remmaTech12/drone2/circuit/multicopter/purchase_order/20250331b/T-1JP8W790621A-1sets-bom_filled.xls

PCBWay Bom Quotation, Product No.:T-1JP8W790621A
Item # | *Designator | *Qty | Manufacturer | *Mfg Part # | Description / Value | *Package/Footprint | Mounting Type | Your Instructions / Notes | *Unit Price(1 set) | *Total | *Delivery Time | *PCBWay Note | Customer Reply | PCBWay Update
1 | J2 | 1 |  |  | Conn_01x02_Pin | Connector_PinHeader_2.54mm:PinHeader_1x02_P2.54mm_Vertical | THT | Don’t need to solder. |  |  |  | Please provide exact part number or component URL | Don’t need to solder anything for this component.
2 | U1 | 1 | CXH |  | ESP32-DEVKITC-32E | ESP32-DEVKITC-32E:MODULE_ESP32-DEVKITC-32E | THT | https://www.alibaba.com/product-detail/2-54mm-Pitch-1x19-pins-Header-1600109002943.html『 』Please solder two 1 x 19 pin sockets. |  |  |  | Please provide exact part number or component URL | Please solder 2.54mm pitch female pin header like this. https://www.mouser.jp/ProductDetail/Harwin/M20-7823242?qs=ulE8k0yEMYaI8GORbWnzlA%3D%3D Number: M20-7823242 Manufacturer: Harwin
3 | R15 | 1 | Vishay / Dale | CRCW06035K10FKEC | 5.1kΩ | Resistor_SMD:R_0603_1608Metric | SMD | https://www.mouser.jp/ProductDetail/Vishay-Dale/CRCW06035K10FKEC | $0.185 | $0.185
4 | R20 | 1 | TDK | MMZ1608S102ATA00 | 1kΩ | Resistor_SMD:R_0603_1608Metric | SMD | https://www.mouser.jp/ProductDetail/TDK/MMZ1608S102ATA00?qs=8Kz9Wu9QwqVBjJnYaU1j7g%3D%3D | $0.063 | $0.063
5 | M1,M2,M3,M4,M5,M6 | 6 | JST Sales America Inc. | S2B-PH-K-S | Motor_DC | Connector_JST:JST_PH_S2B-PH-K_1x02_P2.00mm_Horizontal | THT | https://www.digikey.jp/en/products/detail/jst-sales-america-inc/S2B-PH-K-S/926626 | $0.117 | $0.702
6 | C7 | 1 | Vishay / Vitramon | VJ0603Y682KXBAC31X | 6.8nF | Capacitor_SMD:C_0603_1608Metric | SMD | https://www.mouser.jp/ProductDetail/Vishay-Vitramon/VJ0603Y682KXBAC31X | $0.769 | $0.769 | 7-10 Workdays
7 | C1,C2,C3,C4,C5,C11,C12,C13 | 8 | KYOCERA AVX | 0603ZD226MAT2A | 22uF | Capacitor_SMD:C_0603_1608Metric | SMD | https://www.mouser.jp/ProductDetail/KYOCERA-AVX/0603ZD226MAT2A?qs=sSYV1F9c5cE%2FKdrrBmQkqw%3D%3D | $0.598 | $4.784 | 7-10 Workdays
8 | U3 | 1 | JST Sales America Inc. | B7B-PH-K-S | PMW3901 | Connector_JST:JST_PH_B7B-PH-K_1x07_P2.00mm_Vertical | THT | https://www.digikey.jp/ja/products/detail/jst-sales-america-inc/B7B-PH-K-S/926616?productid=926616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 | $0.201 | $0.201
9 | U6 | 1 | JST Sales America Inc. | B7B-PH-K-S | VL53L1X | Connector_JST:JST_PH_B7B-PH-K_1x07_P2.00mm_Vertical | THT | https://www.digikey.jp/ja/products/detail/jst-sales-america-inc/B7B-PH-K-S/926616?productid=926616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 | $0.201 | $0.201
10 | U4 | 1 | Bosch Sensortec | BNO055 | BNO055 | Package_LGA:LGA-28_5.2x3.8mm_P0.5mm | SMD | https://www.mouser.jp/ProductDetail/Bosch-Sensortec/BNO055?qs=QhAb4EtQfbV8Z2YmISucWw%3D%3D | $9.258 | $9.258
11 | R1,R2,R5,R6,R16,R18 | 6 | Bourns | CR0603-JW-101ELF | 100Ω | Resistor_SMD:R_0603_1608Metric | SMD | https://www.mouser.jp/ProductDetail/Bourns/CR0603-JW-101ELF?qs=jAUlru4btJFOerhakJcyhQ%3D%3D | $0.031 | $0.186 | 7-10 Workdays
12 | R22 | 1 | Pulse Electronics | GBK160808T-221Y-N | 220Ω | Resistor_SMD:R_0603_1608Metric | SMD | https://www.mouser.jp/ProductDetail/Pulse-Electronics/GBK160808T-221Y-N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 | $0.050 | $0.050
13 | L1 | 1 | Vishay / Dale | IHLP2020BZER220M5A | 22uH | Inductor_SMD:L_Vishay_IHLP-2020 | SMD | https://www.mouser.jp/ProductDetail/Vishay-Dale/IHLP2020BZER220M5A?qs=Imq1NPwxi76LTZn5EfE7yw%3D%3D | $1.937 | $1.937 | 7-10 Workdays
14 | C6,C8 | 2 | KYOCERA AVX | KAM15AR71C104KM | 0.1uF | Capacitor_SMD:C_0603_1608Metric | SMD | https://www.mouser.jp/ProductDetail/KYOCERA-AVX/KAM15AR71C104KM?qs=Jm2GQyTW%2FbjvjfiJhcHTCg%3D%3D | $0.147 | $0.294
15 | SW1 | 1 | C&K | KMR231NGLFS | SW_Push | Button_Switch_SMD:SW_Push_1P1T_NO_CK_KMR2 | SMD | https://www.mouser.jp/ProductDetail/CK/KMR231NGLFS?qs=sb%252But3Lm4x1Y5NsXXdZx2g%3D%3D | $0.503 | $0.503
16 | R3,R4,R7,R8,R9,R10,R11,R12,R13,R14,R17,R19 | 12 | Vishay / Beyschlag | MCT06030D1002BP500 | 10kΩ | Resistor_SMD:R_0603_1608Metric | SMD | https://www.mouser.jp/ProductDetail/Vishay-Beyschlag/MCT06030D1002BP500?qs=ncxkyCpAYDAJSzgYSRSsnA%3D%3D | $0.273 | $3.276
17 | U2 | 1 | CYLDCHIP | MT3608 | MT3608 | Package_TO_SOT_SMD:SOT-23-6 | SMD | https://ja.aliexpress.com/item/1005005498022711.html?src=google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 | $0.221 | $0.221
18 | R21 | 1 | Susumu | RG1608P-752-B-T5 | 7.5kΩ | Resistor_SMD:R_0603_1608Metric | SMD | https://www.mouser.jp/ProductDetail/Susumu/RG1608P-752-B-T5 | $0.315 | $0.315
19 | D9 | 1 | Bivar | SM0603UBWC | LED | Diode_SMD:D_0603_1608Metric | SMD | https://www.mouser.jp/ProductDetail/Bivar/SM0603UBWC?qs=hWDdE2Pc5RAVU9aZAE1txQ%3D%3D | $2.030 | $2.030 | 7-10 Workdays
20 | Q1,Q2,Q3,Q4,Q5,Q6 | 6 | Vishay / Siliconix | SQ2310CES-T1_GE3 | SQ2310CES | Package_TO_SOT_SMD:SOT-23 | SMD | https://www.mouser.jp/ProductDetail/Vishay-Siliconix/SQ2310CES-T1_GE3?qs=Imq1NPwxi74Lc2AIGZ7l8A%3D%3D | $0.770 | $4.620 | 7-10 Workdays
21 | D1,D2,D3,D4,D6,D7,D8 | 7 | onsemi / Fairchild | SS34FA | SS34 | Diode_SMD:D_SOD-123F | SMD | https://www.mouser.jp/ProductDetail/onsemi-Fairchild/SS34FA?qs=R26iFe%2FkX%2FK1QUwZdCmBBw%3D%3D | $0.575 | $4.025
 |  |  |  |  |  |  |  |  | Component Cost | $33.62
 |  |  |  |  |  |  |  |  | Assembly Cost | $29.00
 |  |  |  |  |  |  |  |  | PCB Cost | $5.00
 |  |  |  |  |  |  |  |  | V2 Member 2% off | -$0.68
 |  |  |  |  |  |  |  |  | All Total 1 Sets | $66.94
