remmaTech12/drone2/3dprint/bracket_85mm.FCStd

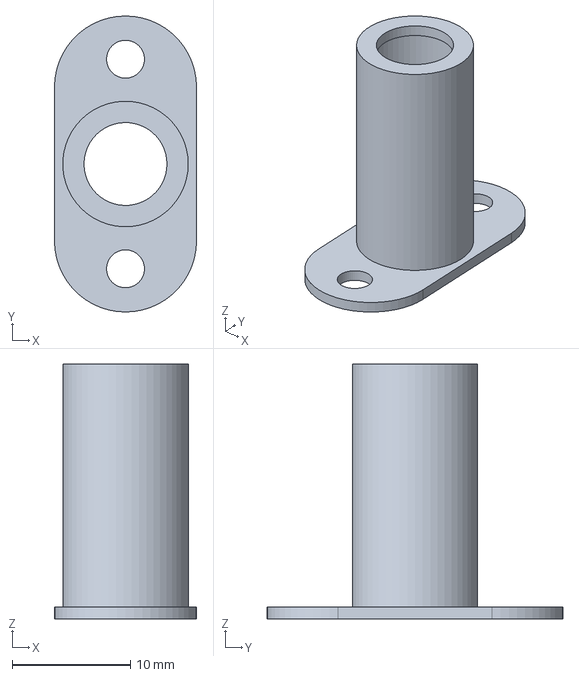
[picture p1: CAD file, 2025-10-11]
3dprint/bracket_85mm.FCStd
12.0 x 25.0 x 21.5 mm
