remmaTech12/drone2/3dprint/quadcopter.FCStd

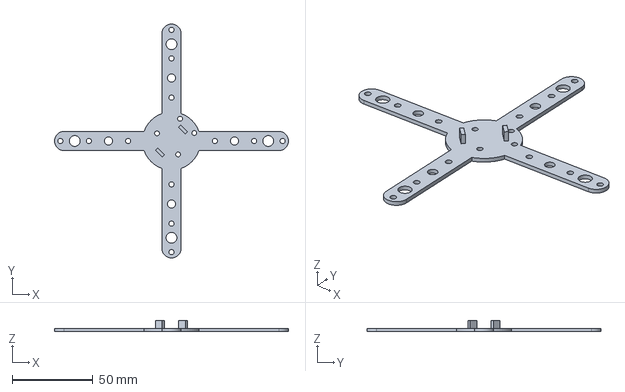
[picture p2: CAD file, 2025-10-06]
3dprint/quadcopter.FCStd
145.0 x 145.0 x 7.00 mm
