remmaTech12/drone2/3dprint/quadcopter_large.FCStd

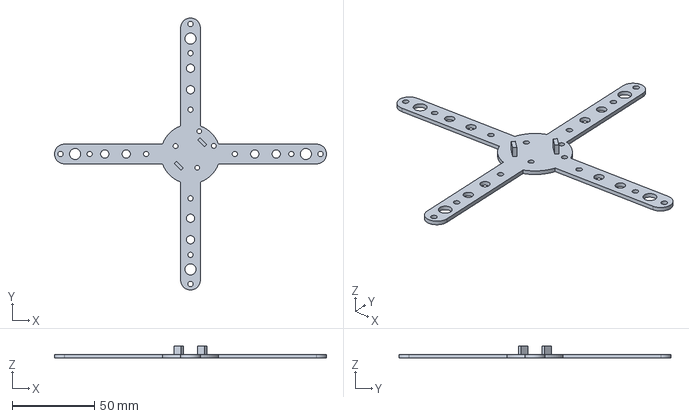
[picture p3: CAD file, 2025-10-06]
3dprint/quadcopter_large.FCStd
165.0 x 165.0 x 7.00 mm
