remmaTech12/drone2/3dprint/bracket_80mm.FCStd

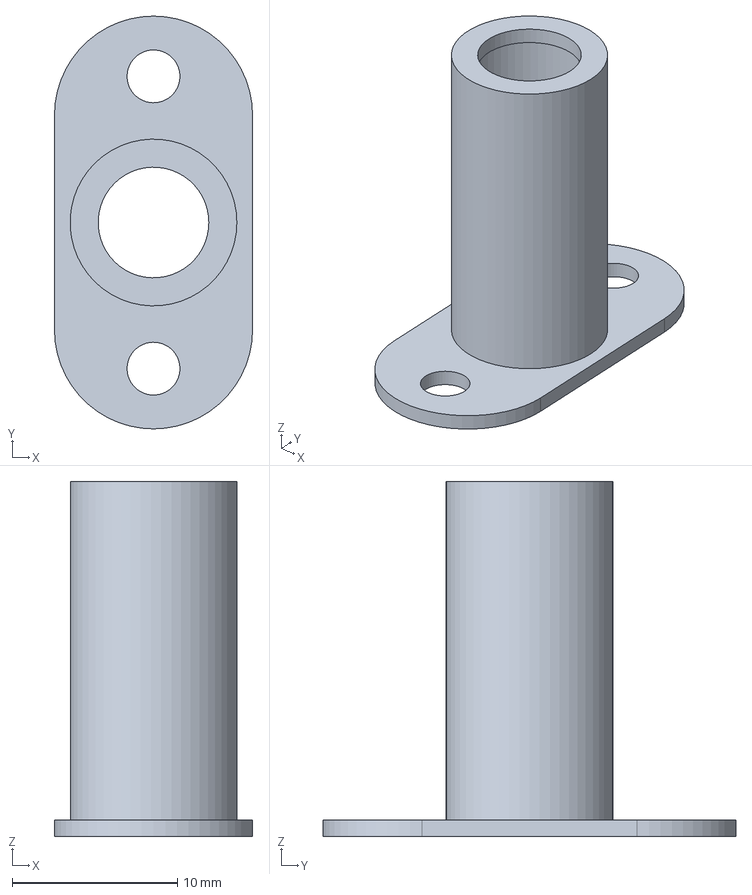
[picture p4: CAD file, 2025-10-06]
3dprint/bracket_80mm.FCStd
12.0 x 25.0 x 21.5 mm
