remmaTech12/drone2/3dprint/bracket.FCStd

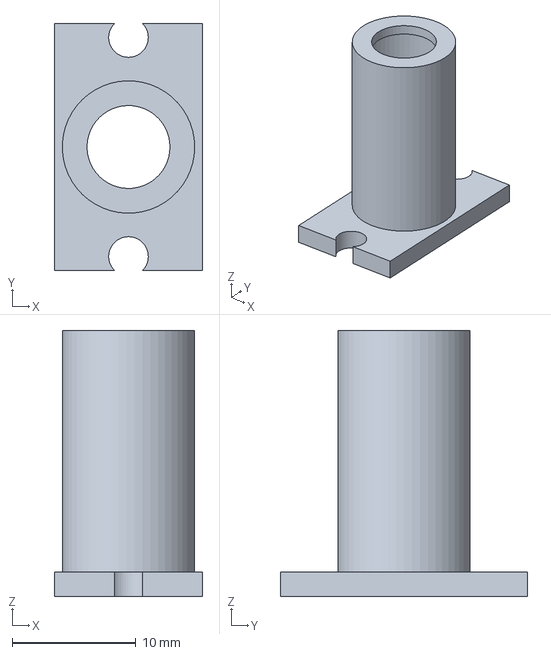
[picture p5: CAD file, 2025-10-06]
3dprint/bracket.FCStd
12.0 x 20.0 x 21.5 mm
