remmaTech12/drone2/3dprint/circuit.FCStd

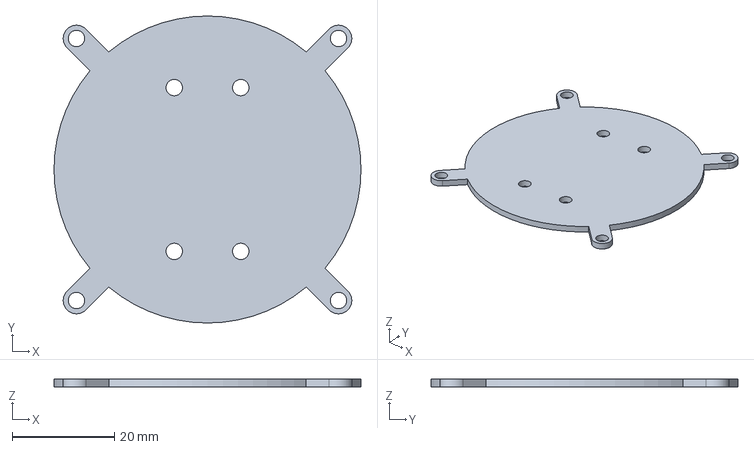
[picture p6: CAD file, 2025-07-03]
3dprint/circuit.FCStd
60.0 x 60.0 x 1.60 mm
