remmaTech12/drone2/3dprint/circuit-Body.dxf

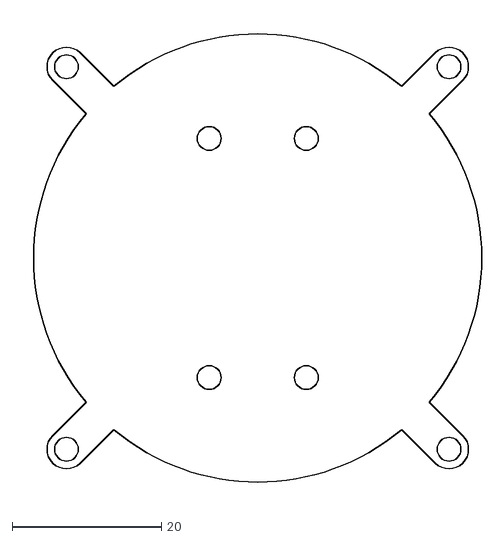
[picture p7: CAD file, 2025-07-03]
3dprint/circuit-Body.dxf
62.3 x 64.7
