remmaTech12/drone2/3dprint/hexacopter_prototype.FCStd

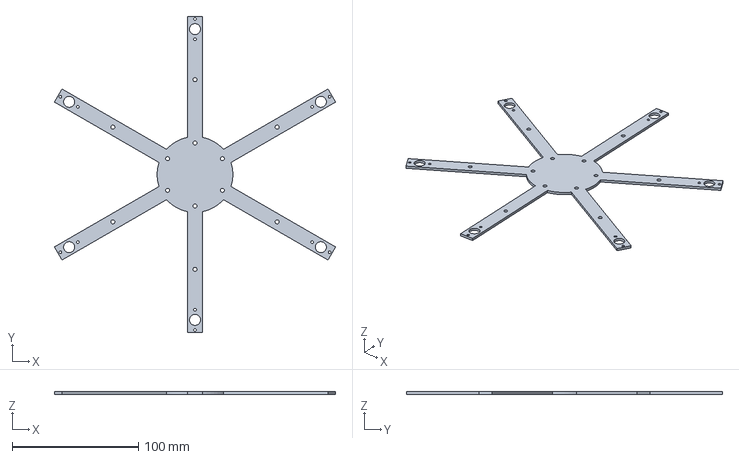
[picture p8: CAD file, 2025-02-15]
3dprint/hexacopter_prototype.FCStd
222.5 x 250.0 x 2.00 mm
