remmaTech12/drone2/(list of files, cad)

Other CAD files:
3dprint/bracket.stl
3dprint/bracket_80mm.stl
3dprint/bracket_85mm.stl
3dprint/hexacopter_prototype.stl
3dprint/quadcopter.stl
3dprint/quadcopter_large.stl
