remmaTech12/drone2/circuit/multicopter/multicopter.kicad_pcb

## KiCad design circuit/multicopter/multicopter.kicad_pcb (2025-07-03)

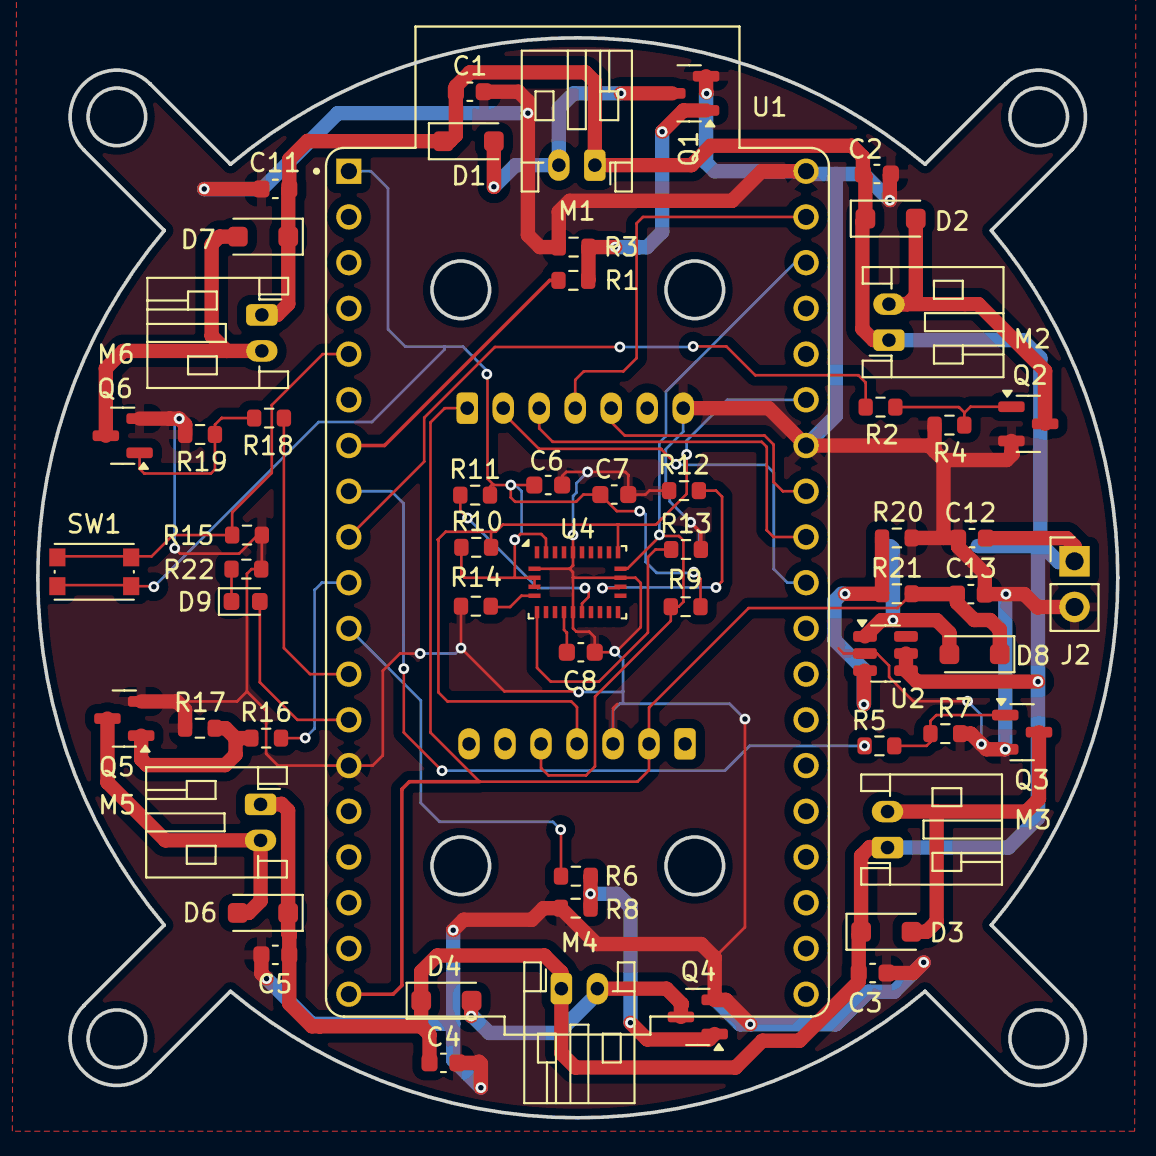
[picture p9: board multicopter.kicad_pcb from above]

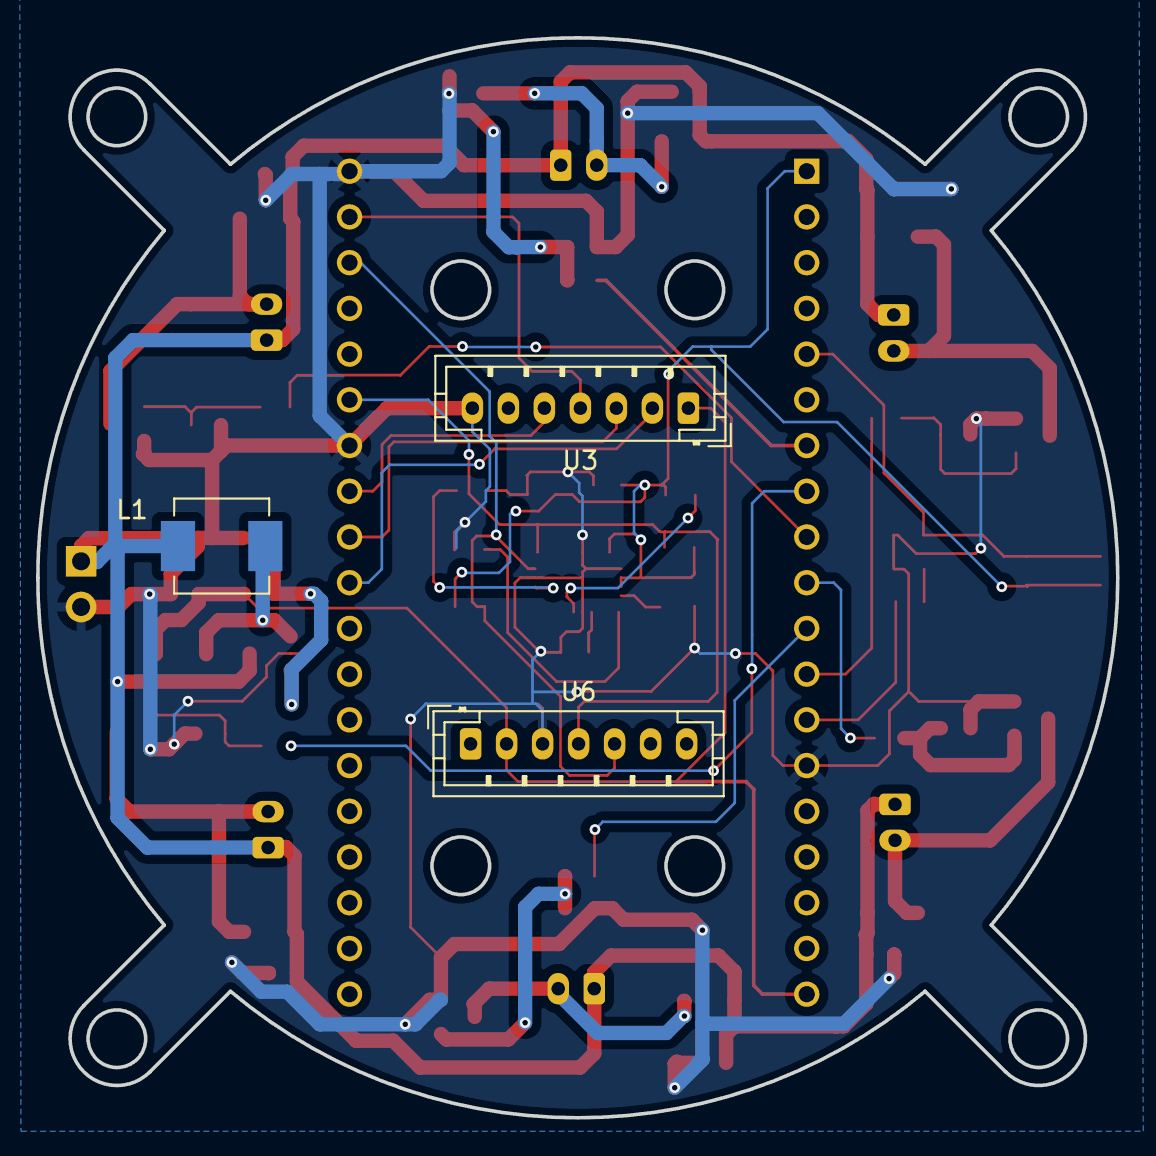
[picture p10: board multicopter.kicad_pcb from below]

Board: 2 copper layers, 60.0 x 60.0 mm, 61 parts (3 on the bottom side), 38 nets.

Parts:
C1, C2, C3, C4, C5, C11, C12, C13: 22uF; C_0603_1608Metric
C6, C8: 0.1uF; C_0603_1608Metric
C7: 6.8nF; C_0603_1608Metric
D1, D2, D3, D4, D6, D7, D8: SS34; D_SOD-123F
D9: LED; D_0603_1608Metric
J2: Conn_01x02_Pin; PinHeader_1x02_P2.54mm_Vertical
L1: 22uH; L_Vishay_IHLP-2020
M1, M2, M3, M4, M5, M6: Motor_DC; JST_PH_S2B-PH-K_1x02_P2.00mm_Horizontal
Q1, Q2, Q3, Q4, Q5, Q6: SQ2310CES; SOT-23
R1, R2, R5, R6, R16, R18: 100Ω; R_0603_1608Metric
R3, R4, R7, R8, R9, R10, R11, R12, R13, R14, R17, R19: 10kΩ; R_0603_1608Metric
R15: 5.1kΩ; R_0603_1608Metric
R20: 1kΩ; R_0603_1608Metric
R21: 7.5kΩ; R_0603_1608Metric
R22: 220Ω; R_0603_1608Metric
SW1: SW_Push; SW_Push_1P1T_NO_CK_KMR2
U1: ESP32-DEVKITC-32E; MODULE_ESP32-DEVKITC-32E
U2: MT3608; SOT-23-6
U3: PMW3901; JST_PH_B7B-PH-K_1x07_P2.00mm_Vertical
U4: BNO055; LGA-28_5.2x3.8mm_P0.5mm
U6: VL53L1X; JST_PH_B7B-PH-K_1x07_P2.00mm_Vertical

Connections:
+3V3: C6.2, C7.2, R9.2, R10.2, R11.2, SW1.1, U1.J2_1 (3V3), U4.3 (VDD), U4.4 (~BOOT_LOAD_PIN), U4.28 (VDDIO)
+5V: C13.1, D8.1 (K), R21.2, U1.J2_19 (EXT_5V), U3.1 (3-5V), U6.2 (VIN)
+BATT: C1.1, C2.1, C3.1, C4.1, C5.1, C11.1, C12.1, D1.1 (K), D2.1 (K), D3.1 (K), D4.1 (K), D6.1 (K), D7.1 (K), J2.1, L1.1, M1.1 (+), M2.1 (+), M3.1 (+), M4.1 (+), M5.1 (+), M6.1 (+), U2.4 (EN), U2.5 (IN)
GND: C1.2, C2.2, C3.2, C4.2, C5.2, C6.1, C7.1, C8.2, C11.2, C12.2, C13.2, J2.2, Q1.2 (S), Q2.2 (S), Q3.2 (S), Q4.2 (S), Q5.2 (S), Q6.2 (S), R3.1, R4.1, R7.1, R8.1, R12.1, R13.2, R14.2, R15.1, R17.1, R19.1, R20.1, R22.1, U1.J2_14 (GND_J2_14), U1.J3_1 (GND_J3_1), U1.J3_7 (GND_J3_7), U2.2 (GND), U3.7 (GND), U4.2 (GND), U4.10 (BL_IND), U4.18 (COM2), U4.25 (GNDIO), U6.3 (GND)
unnamed: D1.2 (A), M1.2 (-), Q1.3 (D)
unnamed: D2.2 (A), M2.2 (-), Q2.3 (D)
unnamed: D3.2 (A), M3.2 (-), Q3.3 (D)
unnamed: D4.2 (A), M4.2 (-), Q4.3 (D)
unnamed: D6.2 (A), M5.2 (-), Q5.3 (D)
unnamed: D7.2 (A), M6.2 (-), Q6.3 (D)
unnamed: D8.2 (A), L1.2, U2.1 (SW)
unnamed: D9.2 (A), U1.J2_13 (IO12)
unnamed: D9.1 (K), R22.2
unnamed: Q1.1 (G), R1.1, R3.2
unnamed: Q2.1 (G), R2.1, R4.2
unnamed: Q3.1 (G), R5.1, R7.2
unnamed: Q4.1 (G), R6.1, R8.2
unnamed: Q5.1 (G), R16.1, R17.2
unnamed: Q6.1 (G), R18.1, R19.2
unnamed: R15.2, SW1.2, U1.J2_5 (IO34)
unnamed: R20.2, R21.1, U2.3 (FB)
unnamed: C8.1, U4.9 (CAP)
unnamed: R12.2, U4.17 (COM3)
unnamed: R13.1, U4.6 (PS0)
unnamed: R14.1, U4.5 (PS1)
unnamed: R11.1, U4.11 (~RESET)
SCL: R9.1, U1.J3_3 (IO22), U4.19 (COM1), U6.5 (SCL)
SDA: R10.1, U1.J3_6 (IO21), U4.20 (COM0), U6.4 (SDA)
SPI_CS0: U1.J3_10 (IO5), U3.2 (CS)
SPI_MISO: U1.J3_8 (IO19), U3.5 (MISO)
SPI_MOSI: U1.J3_2 (IO23), U3.4 (MOSI)
SPI_SCK: U1.J3_9 (IO18), U3.3 (SCK)
motor1: R1.2, U1.J2_7 (IO32)
motor2: R5.2, U1.J2_8 (IO33)
motor3: R2.2, U1.J2_9 (IO25)
motor4: R16.2, U1.J2_10 (IO26)
motor5: R6.2, U1.J2_11 (IO27)
motor6: R18.2, U1.J2_12 (IO14)
