remmaTech12/drone2/software/main/src/control.cpp

#include "../include/control.h"

Control::Control() {}

void Control::setup() {
    set_pos_pid();
    set_ang_pid();
    set_angvel_pid();
    set_angvel_output_filter();
}

void Control::set_pos_pid() {
    // Initialize PID for position (x, y)
    pid_pos_.Kp = {300.0f, 300.0f};
    pid_pos_.Ki = {0.0f, 0.0f};
    pid_pos_.Kd = {0.0f, 0.0f};
    pid_pos_.max_err_i = 2.0f;
    pid_pos_.sampling_time_ms = SAMPLING_POSITION_CONTROL_TIME_MS;

    pid_pos_.d_filter = {LowPassFilter(), LowPassFilter()};
    pid_pos_.d_filter[0].setup(0.1f);
    pid_pos_.d_filter[1].setup(0.1f);

    pid_pos_.err_i = {0.0f, 0.0f};
    pid_pos_.pre_data = {0.0f, 0.0f};

    pid_pos_.ref_data = {0.0f, 0.0f};
    pid_pos_.cur_data = {0.0f, 0.0f};

    pid_pos_.out_data = {0.0f, 0.0f};
    pid_pos_.max_out_data = 0.0f;
}

void Control::set_ang_pid() {
    // Initialize PID for attitude (roll, pitch, yaw)
    pid_ang_.Kp = {22.5f, 22.5f, 22.5f};
    pid_ang_.Ki = {0.5f, 0.5f, 0.5f};
    pid_ang_.Kd = {0.0f, 0.0f, 0.0f};
    pid_ang_.max_err_i = 50.0f;
    pid_ang_.sampling_time_ms = SAMPLING_ATTITUDE_CONTROL_TIME_MS;

    pid_ang_.d_filter = {LowPassFilter(), LowPassFilter(), LowPassFilter()};
    pid_ang_.d_filter[0].setup(0.1f);
    pid_ang_.d_filter[1].setup(0.1f);
    pid_ang_.d_filter[2].setup(0.1f);

    pid_ang_.err_i = {0.0f, 0.0f, 0.0f};
    pid_ang_.pre_data = {0.0f, 0.0f, 0.0f};

    pid_ang_.ref_data = {0.0f, 0.0f, 0.0f};
    pid_ang_.cur_data = {0.0f, 0.0f, 0.0f};

    pid_ang_.out_data = {0.0f, 0.0f, 0.0f};
    pid_ang_.max_out_data = 255.0f;
}

void Control::set_angvel_pid() {
    // Initialize PID for angular velocity (roll, pitch, yaw)
    pid_angvel_.Kp = {0.5f, 0.5f, 0.5f};
    pid_angvel_.Ki = {0.05f, 0.05f, 0.05f};
    pid_angvel_.Kd = {0.1f, 0.1f, 0.1f};
    pid_angvel_.max_err_i = 50.0f;
    pid_angvel_.sampling_time_ms = SAMPLING_ANGVEL_CONTROL_TIME_MS;

    pid_angvel_.d_filter = {LowPassFilter(), LowPassFilter(), LowPassFilter()};
    pid_angvel_.d_filter[0].setup(0.1f);
    pid_angvel_.d_filter[1].setup(0.1f);
    pid_angvel_.d_filter[2].setup(0.1f);

    pid_angvel_.err_i = {0.0f, 0.0f, 0.0f};
    pid_angvel_.pre_data = {0.0f, 0.0f, 0.0f};

    pid_angvel_.ref_data = {0.0f, 0.0f, 0.0f};
    pid_angvel_.cur_data = {0.0f, 0.0f, 0.0f};

    pid_angvel_.out_data = {0.0f, 0.0f, 0.0f};
    pid_angvel_.max_out_data = 255.0f;
}

void Control::set_angvel_output_filter() {
    angvel_output_filter_ = {LowPassFilter(), LowPassFilter(), LowPassFilter()};
    angvel_output_filter_[0].setup(0.1f);
    angvel_output_filter_[1].setup(0.1f);
    angvel_output_filter_[2].setup(0.1f);
}

std::vector<float> Control::calculate_joystick_to_xy_command(int cmd_data[4]) {
    std::vector<float> ref_data(2, 0.0f);
    constexpr float cmd_mid = 127;
    constexpr float dead_zone = 20;
    constexpr float cmd_min = cmd_mid - dead_zone;
    constexpr float cmd_max = cmd_mid + dead_zone;
    constexpr float cmd_gain = 100.0f;
    const int ver_cmd = cmd_data[2];  // vertical
    const int hor_cmd = cmd_data[3];  // horizontal

    if (cmd_min < ver_cmd && ver_cmd < cmd_max) ref_data[0] = 0.0f;
    else ref_data[0] = (float) +(ver_cmd - cmd_mid) / cmd_gain;

    if (cmd_min < hor_cmd && hor_cmd < cmd_max) ref_data[1] = 0.0f;
    else ref_data[1] = (float) -(hor_cmd - cmd_mid) / cmd_gain;

    return ref_data;
}

std::vector<float> Control::calculate_xy_command_to_ang_command(int cmd_data[4]) {
    std::vector<float> ref_data(3, 0.0f);
    ref_data[0] = -pid_pos_.out_data[1];
    ref_data[1] = +pid_pos_.out_data[0];

    double yaw_input_in_arm_threshold = 200;
    if (cmd_data[0] > yaw_input_in_arm_threshold) ref_data[2] = 0;  // exclude the case for arm
    else ref_data[2] = (float) (cmd_data[1] - 127.0f) / 2.0f;

#ifdef DEBUG_POSITON_CONTROL
    Serial.print("Position control command, roll: ");
    Serial.print(ref_data[0]);
    Serial.print(", pitch: ");
    Serial.print(ref_data[1]);
    Serial.print(", yaw: ");
    Serial.println(ref_data[2]);
#endif

    return ref_data;
}

void Control::calculate_pid(PID &pid) {
    for (int i=0; i<pid.ref_data.size(); i++) {
        // P
        const float err_p = pid.ref_data[i] - pid.cur_data[i];
        // I
        pid.err_i[i] += err_p;
        limit_val(pid.err_i[i], -pid.max_err_i, pid.max_err_i);
        // D
        const float err_d = -(pid.cur_data[i] - pid.pre_data[i]) / ((float)pid.sampling_time_ms/1000.0f);
        const float filtered_err_d = pid.d_filter[i].filter(err_d);
        pid.pre_data[i] = pid.cur_data[i];

        // output
        pid.out_data[i] = pid.Kp[i]*err_p
                        + pid.Ki[i]*pid.err_i[i]
                        + pid.Kd[i]*filtered_err_d;
        if (pid.max_out_data > 0.0f) limit_val(pid.out_data[i], -pid.max_out_data, pid.max_out_data);
    }
}

void Control::calculate_pid_pos(int cmd_data[4], float cur_data[2]) {
    pid_pos_.ref_data = calculate_joystick_to_xy_command(cmd_data);
    pid_pos_.cur_data = {cur_data[0], cur_data[1]};
    calculate_pid(pid_pos_);

    // tilt-cone limiter
    const float alpha = std::hypot(pid_pos_.out_data[0], pid_pos_.out_data[1]);
    const float alpha_max = 5.0;
    for (int i=0; i<2; i++) {
        float alpha_ratio = alpha < alpha_max ? 1.0f : alpha_max / alpha;
        pid_pos_.out_data[i] *= alpha_ratio;
    }
}

void Control::calculate_pid_ang(int cmd_data[4], float ang_data[3]) {
    pid_ang_.ref_data = calculate_xy_command_to_ang_command(cmd_data);
    pid_ang_.cur_data = {ang_data[0], ang_data[1], ang_data[2]};
    calculate_pid(pid_ang_);

#ifdef DEBUG_ATTITUDE_CONTROL
    Serial.print("Attitude control command, roll: ");
    Serial.print(pid_ang_.out_data[0]);
    Serial.print(", pitch: ");
    Serial.print(pid_ang_.out_data[1]);
    Serial.print(", yaw: ");
    Serial.println(pid_ang_.out_data[2]);
#endif
}

void Control::calculate_pid_angvel(float angvel_data[3]) {
    pid_angvel_.ref_data = pid_ang_.out_data;
    pid_angvel_.cur_data = {angvel_data[0], angvel_data[1], angvel_data[2]};
    calculate_pid(pid_angvel_);

    pid_angvel_.out_data[0] = angvel_output_filter_[0].filter(pid_angvel_.out_data[0]);
    pid_angvel_.out_data[1] = angvel_output_filter_[1].filter(pid_angvel_.out_data[1]);
    pid_angvel_.out_data[2] = angvel_output_filter_[2].filter(pid_angvel_.out_data[2]);

#ifdef DEBUG_ANGVEL_CONTROL
    Serial.print("Angular velocity control command, roll: ");
    Serial.print(pid_angvel_.out_data[0]);
    Serial.print(", pitch: ");
    Serial.print(pid_angvel_.out_data[1]);
    Serial.print(", yaw: ");
    Serial.println(pid_angvel_.out_data[2]);
#endif
}

void Control::limit_val(float &val, float min, float max) {
    if (val > max) { val = max; }
    if (val < min) { val = min; }
}

void Control::get_control_val(float ctl_data[3]) {
    ctl_data[0] = pid_angvel_.out_data[0];
    ctl_data[1] = pid_angvel_.out_data[1];
    ctl_data[2] = pid_angvel_.out_data[2];
}
