remmaTech12/drone2/software/main/src/motor.cpp

#include "../include/motor.h"

Motor::Motor() {}

void Motor::setup() {
    pinMode(MOTOR_PWM1, OUTPUT);
    pinMode(MOTOR_PWM2, OUTPUT);
    pinMode(MOTOR_PWM5, OUTPUT);
    pinMode(MOTOR_PWM6, OUTPUT);

    analogWrite(MOTOR_PWM1, 0);
    analogWrite(MOTOR_PWM2, 0);
    analogWrite(MOTOR_PWM5, 0);
    analogWrite(MOTOR_PWM6, 0);

    low_pass_filter_.resize(4);
    for (int i = 0; i < 4; i++) {
        low_pass_filter_[i].setup(0.3);
    }
}

void Motor::test_control(int cmd_val, Arm &arm) {
    if (arm.get_arm_status() == false) {
        stop_motor();
        return;
    }

    constexpr int offset = 118;
    int test_val = (cmd_val - offset) * 2.0;
    limit_command(test_val, 0, 255);

    analogWrite(MOTOR_PWM6, test_val);
    analogWrite(MOTOR_PWM5, test_val);
    analogWrite(MOTOR_PWM2, test_val);
    analogWrite(MOTOR_PWM1, test_val);
}

void Motor::limit_command(int &cmd, int min, int max) {
    if (cmd > max) { cmd = max; }
    if (cmd < min) { cmd = min; }
}

void Motor::stop_motor() {
    analogWrite(MOTOR_PWM1, 0);
    analogWrite(MOTOR_PWM2, 0);
    analogWrite(MOTOR_PWM5, 0);
    analogWrite(MOTOR_PWM6, 0);
}

void Motor::control(int cmd_data[4], float ctl_data[3], Arm &arm, float height) {
    if (arm.get_arm_status() == false) { 
        stop_motor();
        return;
    }

    int motor_data[4] = {0, 0, 0, 0};
    const int cmd_thrust = cmd_data[0];
    //cmd_thrust = calculate_thrust_based_on_height(cmd_data, height, thrust_scale);
    calculate_motor_control(ctl_data, motor_data, cmd_thrust);

    // old algorithm
    /*
    for (int i = 0; i < 4; i++) {
        double ctl_limit = LIMIT_MOTOR * (1.0f - thrust_scale);
        limit_command(motor_data[i], 0, ctl_limit);
        motor_data[i] += cmd_thrust;
        motor_data[i] = low_pass_filter_[i].filter(motor_data[i]);
        limit_command(motor_data[i], 0, LIMIT_MOTOR);
    };
    */

    // new algorithm
    int min_motor_data = 1000;
    for (int i = 0; i < 4; i++) {
        min_motor_data = std::min(min_motor_data, motor_data[i]);
    };

    if (min_motor_data < 0) {
        int shift_up = std::abs(min_motor_data);
        for (int i = 0; i < 4; i++) {
            motor_data[i] += shift_up;
        }
    }

    for (int i = 0; i < 4; i++) {
        //motor_data[i] = low_pass_filter_[i].filter(motor_data[i]);
        limit_command(motor_data[i], 0, LIMIT_MOTOR);
    }

    analogWrite(MOTOR_PWM6, motor_data[0]);
    analogWrite(MOTOR_PWM5, motor_data[1]);
    analogWrite(MOTOR_PWM2, motor_data[2]);
    analogWrite(MOTOR_PWM1, motor_data[3]);

#ifdef DEBUG_ANGVEL_COMMAND
    static unsigned long last_print_time_angvel = 0;
    if (millis() - last_print_time_angvel >= 10) {
        last_print_time_angvel = millis();

//        Serial.print("roll_ctrl: ");
        Serial.print(ctl_data[0]);
        Serial.print("\t");
//        Serial.print(", pitch_ctrl: ");
        Serial.print(ctl_data[1]);
        Serial.print("\t");
//        Serial.print(", yaw_ctrl: ");
        Serial.println(ctl_data[2]);

#endif

#ifdef DEBUG_MOTOR_COMMAND
    static unsigned long last_print_time_motor = 0;
    if (millis() - last_print_time_motor >= 10) {
        last_print_time_motor = millis();

//        Serial.print("MOTOR COMMAND: ");
//        Serial.print("motor0: ");
        Serial.print(motor_data[0]);
        Serial.print("\t");
//        Serial.print(", motor1: ");
        Serial.print(motor_data[1]);
        Serial.print("\t");
//        Serial.print(", motor2: ");
        Serial.print(motor_data[2]);
        Serial.print("\t");
//        Serial.print(", motor3: ");
        Serial.println(motor_data[3]);
    }
#endif
}

int Motor::calculate_thrust(double thrust_scale, int cmd_data[4]) {
    constexpr double kth = 40;
    constexpr double kth_scale = 3.0;
    if (cmd_data[0] < kth) {
        cmd_data[0] *= kth_scale;
    } else {
        cmd_data[0] = ((LIMIT_MOTOR - kth_scale*kth) / (LIMIT_MOTOR - kth)) * (cmd_data[0] - kth) + kth_scale*kth;
    }
    int cmd_thrust = cmd_data[0]*thrust_scale;
    limit_command(cmd_thrust, 0, LIMIT_MOTOR*thrust_scale);

    return cmd_thrust;
}

int Motor::calculate_thrust_based_on_height(int cmd_data[4], float height, double thrust_scale) {
    // TODO: should be in control.cpp
    constexpr double max_height = 200.0;
    constexpr double max_cmd_thrust = 255.0;
    const double raw_cmd_thrust = cmd_data[0];
    const double target_height = max_height / max_cmd_thrust * raw_cmd_thrust;

    constexpr double Kp = 1.0;
    constexpr double Ki = 0.0;

    const double err_height = target_height - height;
    const double dt = SAMPLING_ANGVEL_CONTROL_TIME_MS / 1000.0;
    err_height_i_ += err_height * dt;
    err_height_i_ = std::clamp(err_height_i_, -500.0, 500.0);

    int cmd_thrust = Kp * err_height + Ki * err_height_i_;
    constexpr int offset_thrust = 50;
    constexpr int offset_thrust_threshold = 100;
    if (raw_cmd_thrust > offset_thrust_threshold) cmd_thrust += offset_thrust;
    limit_command(cmd_thrust, 0, LIMIT_MOTOR*thrust_scale);

    return cmd_thrust;
}

void Motor::calculate_motor_control(float ctl_data[3], int motor_data[4], int cmd_thrust) {
    float offset_motor[4] = {0.0f, 0.0f, 0.0f, 0.0f};
    constexpr float yaw_constant = 1.0f;
    motor_data[0] = + ctl_data[0] - ctl_data[1] - ctl_data[2] * yaw_constant + offset_motor[0] + cmd_thrust;
    motor_data[1] = + ctl_data[0] + ctl_data[1] + ctl_data[2] * yaw_constant + offset_motor[1] + cmd_thrust;
    motor_data[2] = - ctl_data[0] + ctl_data[1] - ctl_data[2] * yaw_constant + offset_motor[2] + cmd_thrust;
    motor_data[3] = - ctl_data[0] - ctl_data[1] + ctl_data[2] * yaw_constant + offset_motor[3] + cmd_thrust;
}
