remmaTech12/drone2/software/main/include/arm.h

#pragma once
#include "Arduino.h"
#include "def_system.h"

class Arm {
   public:
    Arm();

    void setup();
    void set_arm_status(bool armed);
    bool get_arm_status();

   private:
    bool m_armed = false;
};
