remmaTech12/drone2/(commit log)

2025-02-15 initial commit: rotate one motor.
    [bracket.FCStd, bracket.stl, hexacopter_prototype.FCStd, hexacopter_prototype.stl, motors.kicad_sch, multicopter.kicad_pcb, multicopter.kicad_sch]
2025-02-18 rotate 6 motors.
2025-03-02 use motor pwm variable.
2025-03-02 add vl53l1x ToF sensor.
2025-03-09 add multicopter breadboard circuit
    [motors.kicad_sch, multicopter_breadboard.kicad_pcb, multicopter_breadboard.kicad_sch]
2025-03-16 completed schematic.
    [motors.kicad_sch, multicopter.kicad_sch]
2025-07-03 added circuits.
    [T-1JP8W790621A-1sets-bom_filled.xls, T-1JP8W790621A-IQC-BOM.xlsx, T-1JP8W790621A-IQC-BOM_answered_20250427a.xlsx, bom.csv, bom.xlsx, bom1.xlsx, bom2.xlsx, motors.kicad_sch]
2025-07-03 add 3d prints.
    [circuit-Body.dxf, circuit.FCStd]
2025-09-19 add 3d print parts.
    [bracket.FCStd, bracket.stl, quadcopter.FCStd, quadcopter.stl]
2025-09-21 set the correct pin number for motors.
    [def_system.h]
2025-09-24 tidy up 3d print components.
    [bracket.FCStd, bracket.stl, quadcopter.FCStd, quadcopter.stl]
2025-09-24 Fixed motor number definition.
    [def_system.h]
2025-09-24 button uses pull down actually.
2025-09-24 Utilize the current bluetooth mac address.
2025-09-24 succeeded in test motor control.
2025-09-25 rotate motor soon after connected to controller.
2025-09-26 Revert "temporary commit: use BLE instead of bluetooth classic."
    This reverts commit a20dd4facde794c9bfc8b75720899871815be649.
    [def_system.h, imu_bno055.cpp, main.ino, recv.cpp, recv.h]
2025-09-28 add optical flow sensor.
2025-09-28 add tof sensor.
2025-09-29 fixed an issue of receive data from transmitter (need to check data ready).
    [main.ino, motor.cpp, recv.cpp, tof_vl53l1x.cpp]
2025-10-04 separate led functions.
2025-10-04 revise the 3d print part cad files.
    [quadcopter.FCStd, quadcopter.stl]
2025-10-04 added madgwick filter and euler angle calculation.
2025-10-04 not use magnetic sensor of IMU.
2025-10-04 add coordinate transformation for optical flow sensor.
2025-10-04 add led on/off code.
2025-10-04 turn on led when armed.
2025-10-05 fixed motor pin allocation.
    [motor.cpp]
2025-10-05 update 3d print parts.
    [bracket.FCStd, quadcopter.FCStd, quadcopter_large.FCStd, quadcopter_large.stl]
2025-10-05 add getter function for tof sensor.
2025-10-05 added an algorithm of thrust calculation based on height.
2025-10-05 add i control for thrust based on height.
2025-10-06 utilize optical flow data for attitude control.
2025-10-06 add calibration.
2025-10-06 add 3dprint data.
    [bracket.FCStd, bracket_80mm.FCStd, bracket_80mm.stl, quadcopter.FCStd, quadcopter_large.FCStd]
2025-10-07 separate control frequency for outer and inner and remove pid.h/pid.cpp.
2025-10-07 bug fix for neutral command.
    [main.ino]
2025-10-08 tune PID gain.
2025-10-08 tune the maximum integral term and low pass filter parameter.
2025-10-08 add offset for roll and pitch angles.
2025-10-08 remove offsets for motors and use previous thrust calculation algorithm.
2025-10-08 add moving average to eliminate noise.
    [flow_pmw3901.cpp, flow_pmw3901.h]
2025-10-08 add library for low pass filter and moving average.
2025-10-08 calculate position deviation and velocity.
2025-10-08 get float data for flow sensor.
2025-10-08 add position control with flow sensor.
2025-10-09 remove bias and calibration, and add debug sentence for imu.
2025-10-09 quit integral of flow sensor.
2025-10-09 raise thrust scale.
2025-10-09 add offset for pitch angle.
2025-10-10 add low pass filter for motor commands.
2025-10-10 successful flight: shorten position control cycle.
    [def_system.h]
2025-10-11 check nan or inf for imu sensor.
2025-10-11 add motor bracket 3dprint files.
    [bracket_85mm.FCStd, bracket_85mm.stl]
2025-10-11 simplified pid calculation source code.
2025-10-11 Created a function to calculate PID.
2025-10-11 use new pid algorithm for attitude control.
2025-10-11 refactor flow sensor code.
2025-10-11 imu refactoring done.
2025-10-11 refactor for motor is done.
2025-10-11 refacor for flow sensor is done.
2025-10-18 bug fix for angle initialization.
    [imu_bno055.cpp]
2025-10-18 good performance without thrust scale.
